ForgemAR/rocket-tip-creation/spitze-rekonstruktion.org

* Projekt Spitzenrekonstruktion

** Konstruktionsskizze Spitze

[[file:spitze-konstruktion.pdf][Skizze]]

** Emailverkehr Bernd/David/Michael

[[message://5352643B.2050104@t-online.de][Alternativlos ist nur die Bundeskanzlerin_ Raketenspitzenantennenhilfe, V2.0]]
[[message://5352B335.1040501@t-online.de][Korrektur im Anhang, Unterabschnitt 6.2:  Feldstärke war zu hoch angesetzt]]
[[message://534F8B0B.3000901@t-online.de][Re: Raketenspitzenantennenhilfe]]
[[message://534FA1B0.2040901@gmx.de][Re: Raketenspitzenantennenhilfe]]
[[message://534FCAE4.9010704@woelky.net][Re: Raketenspitzenantennenhilfe]]
[[message://5353A90D.90109@t-online.de][Re: Alternativlos ist nur die Bundeskanzlerin_ Raketenspitzenantennenhilfe, V2.0]]
[[message://534D9E95.9000203@t-online.de][Re: Raketenspitzenantennenhilfe]]
