ForgemAR/rocket-tip-creation/spitze-konstruktion.pdf

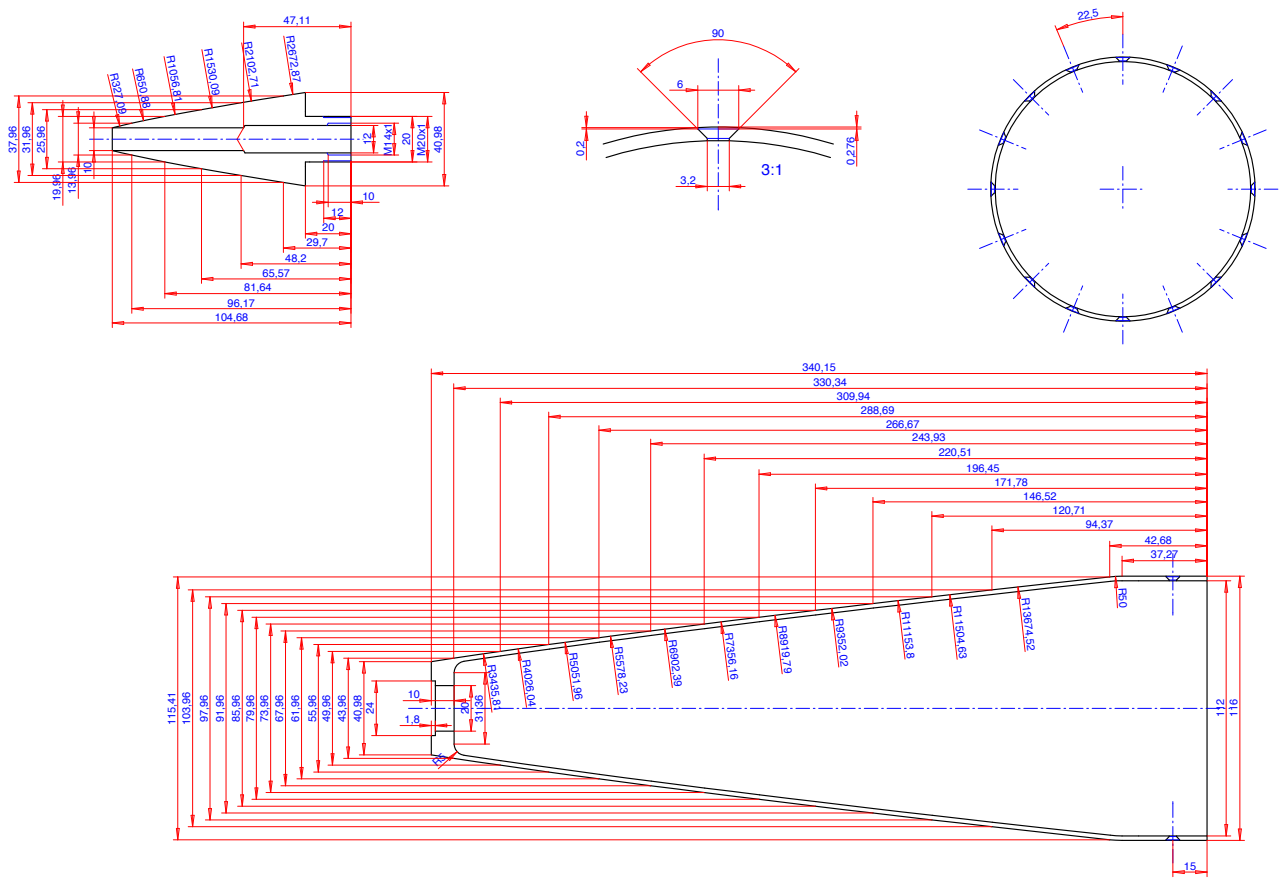
[picture p3: page 1]
