ForgemAR/rocket-tip-creation/spitze-konstruktion.pdf

3:1
